larszi/marax-pressure-mod/doc/hardware/hardware.md

# Hardware Info 

## [Arduino Nano 33 IOT, SAMD21G18A](https://www.reichelt.de/arduino-nano-33-iot-samd21g18a-mit-header-ard-nano-33iot-h-p261303.html)
I choose this arduino because it has a lot of capability's -> Wifi on Board and quite a bit of compute power. If I would to rebuilding this project I think I would go with some STM chip and a proper development SDK

## [Pressure Sensor G1/4 5V](https://de.aliexpress.com/item/4000756631924.html?gatewayAdapt=glo2deu)
## [230V AC Dimmer](https://de.aliexpress.com/item/32802025086.html?gatewayAdapt=glo2deu)
## [5mm T-conneter](https://www.landefeld.de/artikel/de/t-steckanschluss-5mm-5mm-iqs-msv-standard-/IQST%2050%20MSV)
##  5mm high pressure pipe
Some think [like](https://www.ebay.de/itm/132292939013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), as I cant remember where I ordered these. 
## [Wires - blue](https://www.ebay.de/itm/175024020997?var=474179865864)
## [Wires - red](https://www.ebay.de/itm/185166398802?var=692922689357)
## [Some general wires](https://www.ebay.de/itm/275161706396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)
## [Some Wago connectors](https://www.wago.com/de/c/installationsklemmen)
## [5mm to G1/4 Adapter](https://www.landefeld.de/artikel/de/steckanschluss-m-innengew-g-14-5mm-iqs-msv-standard-/IQSF%20145%20MSV)
## [Nextion 2.4 Touchscreen](https://de.aliexpress.com/item/1005003834419474.html?gatewayAdapt=glo2deu)
## [Nextion 2.4 Touchscreen](https://de.aliexpress.com/item/1005003834419474.html?gatewayAdapt=glo2deu)
## [PCB Board](https://www.amazon.de/-/en/GeeekPi-Breadboard-Experimental-Soldering-Double-Sided/dp/B07G5CRQXK/259-7133951-6754467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)

## [A Relay](https://www.ebay.de/itm/322959883722)

## [Case for the Display (3D printed)](https://www.thingiverse.com/thing:3611737)
