larszi/marax-pressure-mod/doc/hardware/aliexpress-shopping-list.md

# Hardware Aliexpress Shopping list

## Arduino Nano 33 IOT [SAMD21G18A - ABX00027]

- [Option A](https://www.aliexpress.com/item/1005005112308672.html) - US$ 48.26 + 4.99 Shipping
  
- [Option B](https://www.aliexpress.com/item/1005001701139619.html) - US$ 62.23 + 4.69 Shipping

## Pressure Sensor [G1/4 5V]

- [Option A](https://aliexpress.com/item/4000756631924.html) - US$ 17.75 - Free Shipping
  
- [Option B](https://www.aliexpress.com/item/1005002409804327.html) - US$ 17.01 - Free Shipping (select option: G1 4 CU)

## 230V AC Dimmer

- [Option A](https://www.aliexpress.com/item/32802025086.html) - US$ 3.72 + 1.84 Shipping (select option: Dimmer 4A-400V)

## 5mm T Connect

- [Option A](https://www.aliexpress.com/item/1005003478292726.html) - US$ $1.99 + 1.38 Shipping (select option: Color: 5mm)
  
- [Option B](https://www.aliexpress.com/item/1005005379019912.html) - US$ 1.73 + 0.4 Shipping (select option: PE-5)
  
  Full metalic options you need to assamble it. Maybe it works better with high heat:
  
- Option C (DIY from 3x(5-01 & PC) + 1x(1l8 Square tee F))
  
  - Get 1x [5 pcs Quick Fitting](www.aliexpress.com/item/1005002990608089.html) - US$ 3.0 + 1.46 Shipping (select option: 5-01 & PC) (It contains 5pcs)
    
  - Get 1x [T Fitting](https://www.aliexpress.com/item/1005002721335216.html) - US$ 0.49 - Free Shipping (select option: 1l8 Square tee F)
    
- Option D (DIY from 3x(PC5-01) + 1x(Inside 1-8))
  
  - Get 1x [10 pcs Quick Fitting](https://www.aliexpress.com/item/1005005299897937.html) - US$ 3.81 + 2.41 Shipping (select option: PC5-01)
    
  - Get 1x [T Fitting](https://www.aliexpress.com/item/30000001452330.html) - US$ 1.72 + 1.22 Shipping (select option: Inside 1-8)

## 5mm Pneumatic Hose (High pressure) [ODxID - 5x3mm]

- [Option A](https://www.aliexpress.com/item/1005001774849589.html) - US$ 11.63 - Free Shipping (select option: 5X3)
  
- [Option B](https://www.aliexpress.com/item/1005004554143434.html) - US$ 8.20 + 5.81 Shipping (select option: 5X3-5M)
  
- [Option C](https://www.aliexpress.com/item/1005004784118956.html) - US$ 1.78 + 1.49 Shipping (select option: ID 3xOD 5mm)

## Blue Heat Resistant Cable

- [Option A](https://www.aliexpress.com/item/4000603135937.html) - US$ 2.77 + Free Shipping (select option: blue 2m & 1mm2 (17AWG))

## Red Heat Resistant Cable

- [Option A](https://www.aliexpress.com/item/4000603135937.html) - US$ 2.77 + Free Shipping (select option: red 2m & 1mm2 (17AWG))

## Data Cable

- [Option A](https://www.aliexpress.com/item/1005001709061491.html) - US$ 5.88 + Free Shipping (select option: 5m & 26AWG & 4 core)
  
- [Option B](https://www.aliexpress.com/item/1005003923049258.html) - US$ 6.68 + Free Shipping (select option: 5m & 26AWG & 4 core)

## 1-Way Wire Connector

- [Option A](https://www.aliexpress.com/item/1005003655645428.html) - US$ 1.85 + Free Shipping (select option: NC-221 + 5pcs)

## 2-Way Wire Connector

- [Option A](https://www.aliexpress.com/item/4000246173921.html) - US$ 2.35 + Free Shipping (select option: 2way & 10pcs)
  
- [Option B](https://www.aliexpress.com/item/4000246173921.html) - US$ 1.71 + Free Shipping

## 3-Way Wire Connector

- [Option A](https://www.aliexpress.com/item/4000246173921.html) - US$ 3.04 + Free Shipping (select option: 3way & 10pcs)

## G1/4 to 5mm Hose Converter

- Option A
  
  - Get [G1/4 to 5x3mm hose converter](https://www.aliexpress.com/item/1005004397427551.html) US$ 10.15 + Free Shipping
    
  - Get [G1/4 female to female extender](https://www.aliexpress.com/item/4001134489290.html) - US$ 4.73 - Free Shipping (select option: 30mm)
    
- Option B
  
  - use one Quick fitting if you ordered Option C (contains: (5-01 & PC)) or D (contains: (PC5-01)) from T Connect.
  
  - [1/8 to 1/4 adapter](https://www.aliexpress.com/item/1005002247474319.html) - US$ 1.04 - Free Shipping (select option: 1I8-1I4)  

## Nextion 2.4 Touch Screen (NX3224F024)

- [Option A](https://www.aliexpress.com/item/1005003834419474.html) - US$ 21.03 + 5.41 Shipping
  
- [Option B](https://www.aliexpress.com/item/32700700427.html) - US$ 23.37 + 5.99 Shipping (select option: NX3224F024-Discovery)

## DC 3V/3.3V Relay

- [Option A](https://www.aliexpress.com/item/1005001308807613.html) - US$ 1.09 + 1.67 Shipping
  
- [Option B](https://www.aliexpress.com/item/4001143185669.html) - US$ 1.88 + 1.15 Shipping

## Proto Breadboard (Half Size)

- [Option A](https://www.aliexpress.com/item/4000372753001.html) - US$ 1.52 + 1.11 Shipping (select option: Half Sized with any color)
